servodevelop/touch-r1-leader-arm/hardware/robot-description/README.zh.md

# Touch R1 Leader Arm 机器人描述

文档已统一使用中文，正文请查看 [当前文档](README.md)。

[查看：下载与预览](README.md#preview)

[查看：模型来源](README.md#sources)

[查看：关节与坐标](README.md#kinematics)

[查看：待确认参数](README.md#confirmation)

[查看：验证与重新生成](README.md#validation)
