servodevelop/touch-r1-leader-arm/hardware/robot-description/preview/index.html

# Touch R1 Leader Arm

V3.2 · J7 舵机与双 Finger · 七轴运动学预览

预览草案 · 实机参数待确认

装配姿态 / 关节零位

七个舵机已装配 · 橙色为左右 Finger

结构件舵机旋转轴

正在加载 URDF 和 CAD 网格…

拖动旋转视角 · 滚轮缩放 · 右键平移

## 关节角度

拖动滑块查看运动。0° 对应源装配姿态。J1–J6 ±90°、J7 0–25° 仅为演示范围。

恢复装配姿态视角复位

显示旋转轴 按连杆着色

双 Finger 按 CAD 齿形推定 1:1 反向联动，待实物确认。实机限位、编码器零位和正方向未确认；未加入碰撞检测、质量及惯量。仅用于外形与运动学核对。

下载 URDF完整资源包

URDF 使用米与弧度。A000、B000 限位块已移除。舵盘随下游连杆旋转，机壳随上游连杆移动。
