servodevelop/touch-r1-leader-arm/hardware/step/parts/touch-r1-handle-assembly.step

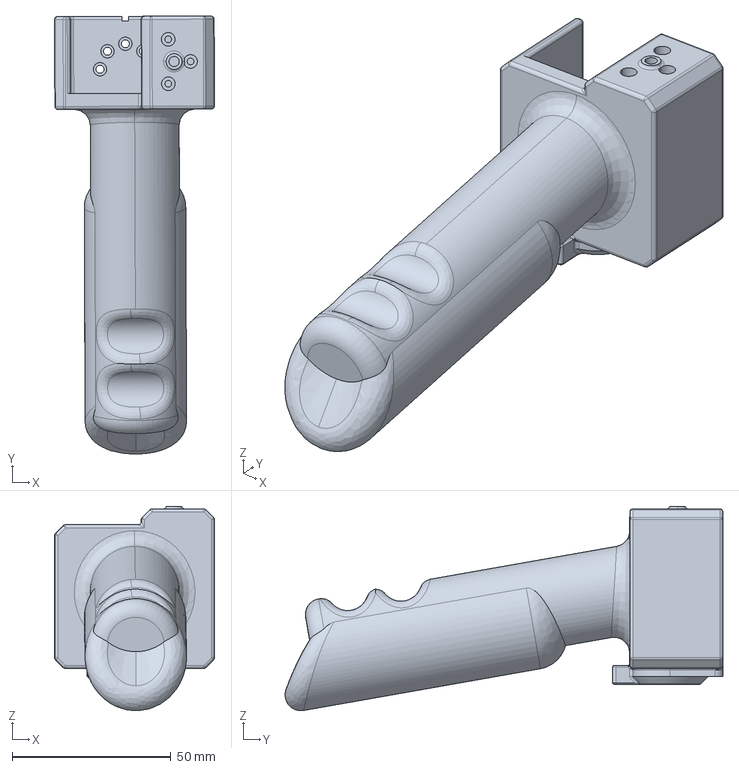
[picture p21: CAD file, 2026-10-23]
hardware/step/parts/touch-r1-handle-assembly.step
50.4 x 138.0 x 64.4 mm
