servodevelop/touch-r1-leader-arm/hardware/printing/stl/touch-r1-part-a000.stl

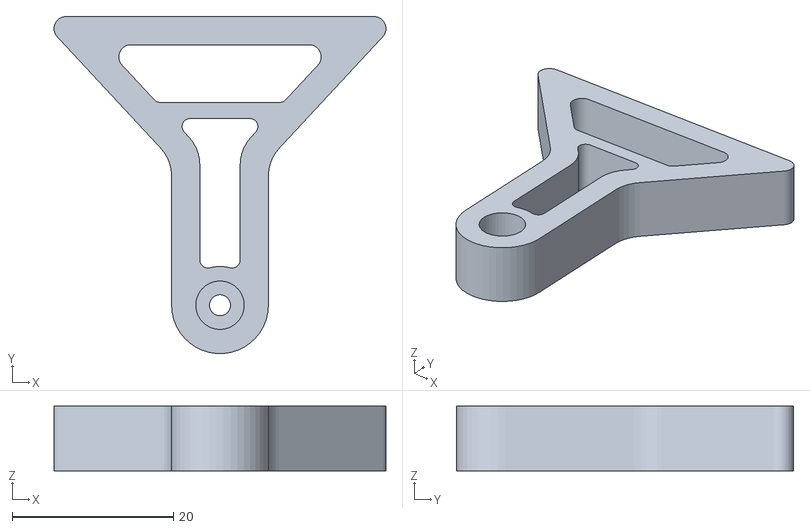
[picture p22: CAD file, 2026-10-23]
hardware/printing/stl/touch-r1-part-a000.stl
41.1 x 41.7 x 8.00
