servodevelop/touch-r1-leader-arm/hardware/robot-description/source/r1-hd-urdf-only.FCStd

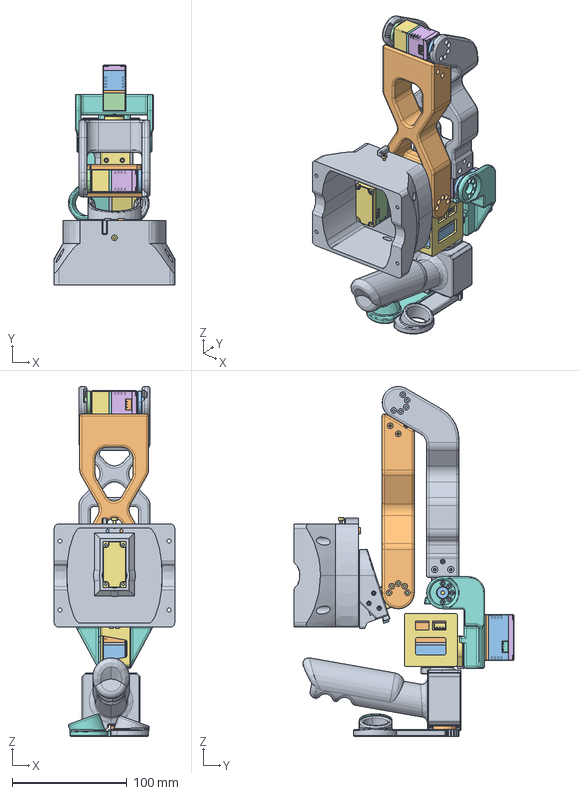
[picture p23: CAD file, 2026-10-21]
hardware/robot-description/source/r1-hd-urdf-only.FCStd
105.0 x 191.5 x 304.9 mm
_X2_51738282_X0_1_NEW
MAIN-HORN-25T-8HOLES-3D_STEP_1_
_________RA8-RP8-RX8-SERIES-3D_
____-_____RA8-RP8-RX8-SERIES-3D
_____________RA8-RP8-RX8-SERIES
_________1_STEP
_X2_57AB7247_X0_
_X2_51738282_X0_2__X2_65B0_X0_
PRT0001
PRT0002
_X2_51738282_X0_3
_X2_51738282_X0_4
_X2_51738282_X0_5_NEW
MAIN-HORN-25T-8HOLES-3D_STEP_1_001
_________RA8-RP8-RX8-SERIES-3D_001
____-_____RA8-RP8-RX8-SERIES-3D001
_____________RA8-RP8-RX8-SERIES001
_________1_STEP001
_X2_51738282_X0_6_NEW
MAIN-HORN-25T-8HOLES-3D_STEP_1_002
_________RA8-RP8-RX8-SERIES-3D_002
____-_____RA8-RP8-RX8-SERIES-3D002
_____________RA8-RP8-RX8-SERIES002
_________1_STEP002
GB_T70_1-M3X400
M2X4X30001
M2X4X30002
MAIN-HORN-25T-8HOLES-3D_STEP_1_003
_________RA8-RP8-RX8-SERIES-3D_003
____-_____RA8-RP8-RX8-SERIES-3D003
_____________RA8-RP8-RX8-SERIES003
_________1_STEP003
LEFT_ZHUA
RIGHT_ZHUA
