servodevelop/touch-r1-leader-arm/hardware/step/parts/touch-r1-joint-4.step

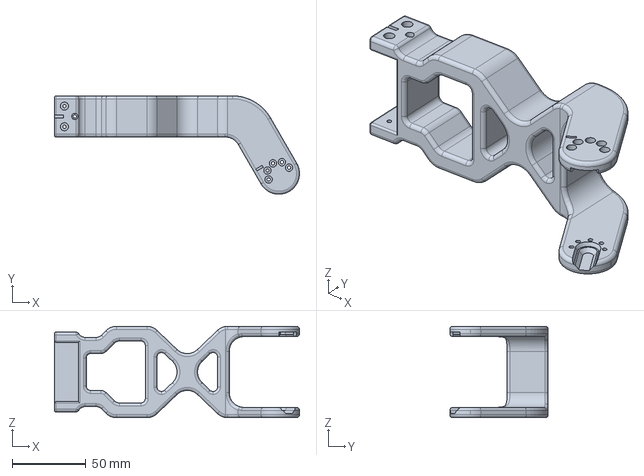
[picture p25: CAD file, 2026-10-23]
hardware/step/parts/touch-r1-joint-4.step
166.2 x 66.7 x 62.0 mm
