servodevelop/touch-r1-leader-arm/hardware/stl/touch-r1-joint-6.stl

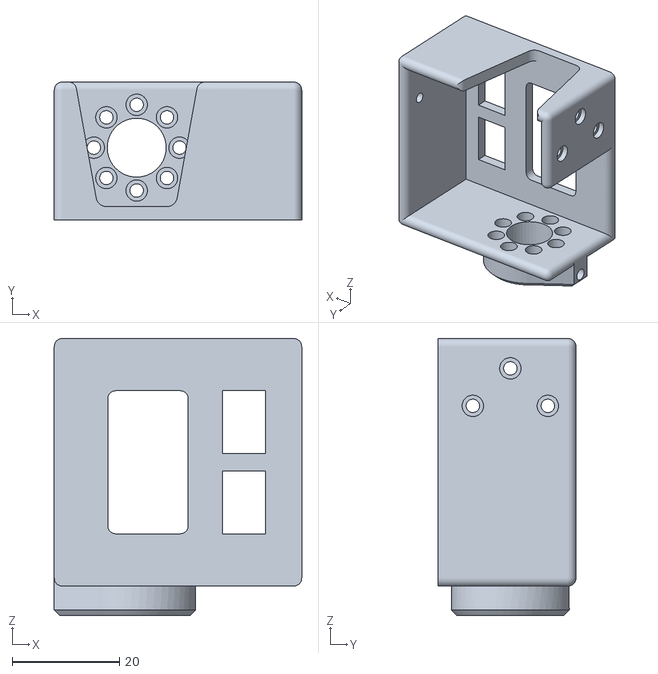
[picture p26: CAD file, 2026-10-23]
hardware/stl/touch-r1-joint-6.stl
46.2 x 25.8 x 51.7
