servodevelop/touch-r1-leader-arm/hardware/step/parts/touch-r1-joint-1.step

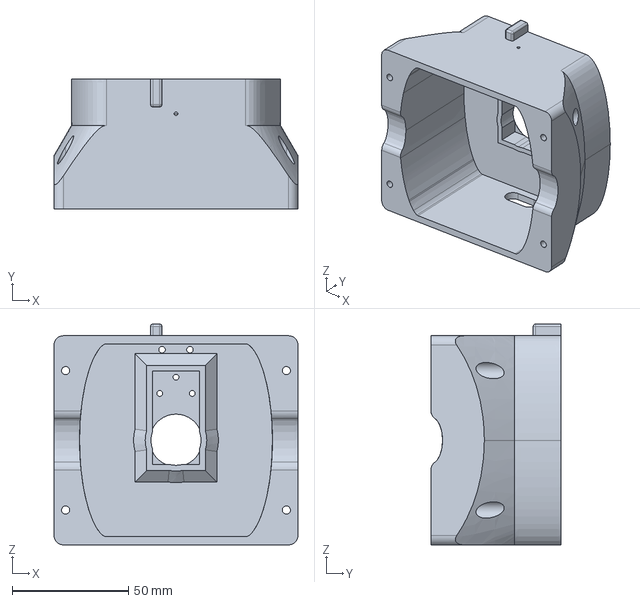
[picture p27: CAD file, 2026-10-23]
hardware/step/parts/touch-r1-joint-1.step
105.0 x 56.0 x 95.0 mm
