servodevelop/touch-r1-leader-arm/hardware/step/parts/touch-r1-joint-3.step

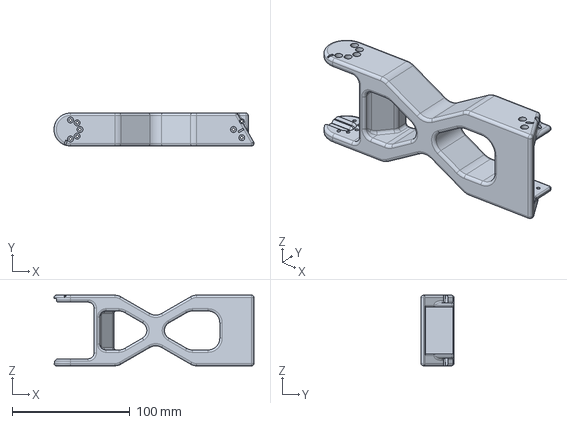
[picture p28: CAD file, 2026-10-23]
hardware/step/parts/touch-r1-joint-3.step
169.8 x 28.0 x 60.0 mm
