servodevelop/touch-r1-leader-arm/hardware/step/parts/touch-r1-joint-5.step

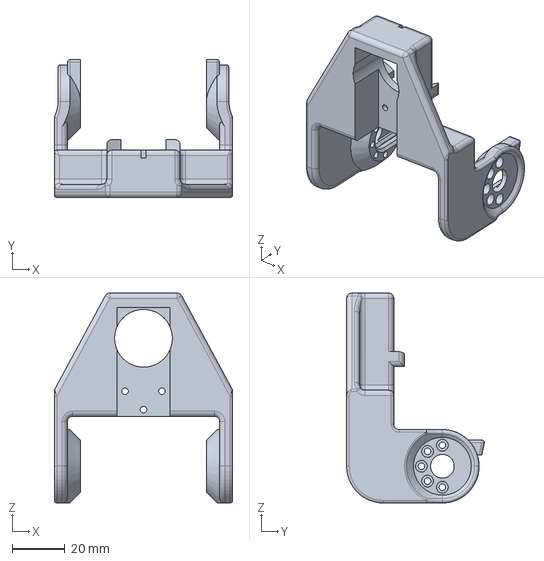
[picture p29: CAD file, 2026-10-23]
hardware/step/parts/touch-r1-joint-5.step
68.0 x 52.5 x 80.0 mm
