servodevelop/touch-r1-leader-arm/hardware/step/parts/touch-r1-joint-2.step

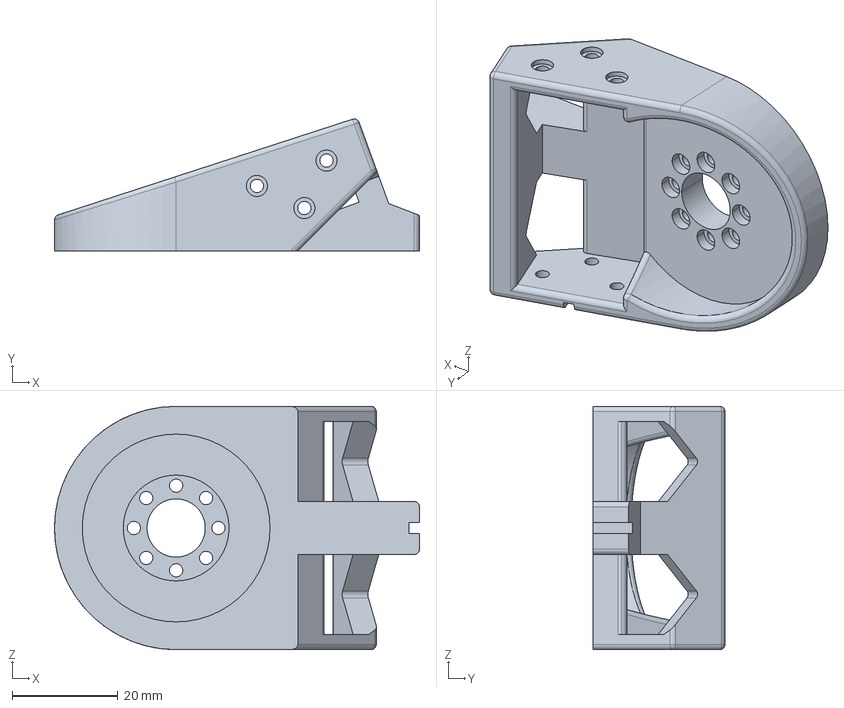
[picture p30: CAD file, 2026-10-23]
hardware/step/parts/touch-r1-joint-2.step
69.0 x 25.0 x 46.0 mm
