servodevelop/touch-r1-leader-arm/hardware/step/parts/touch-r1-fastener-prt0007.step

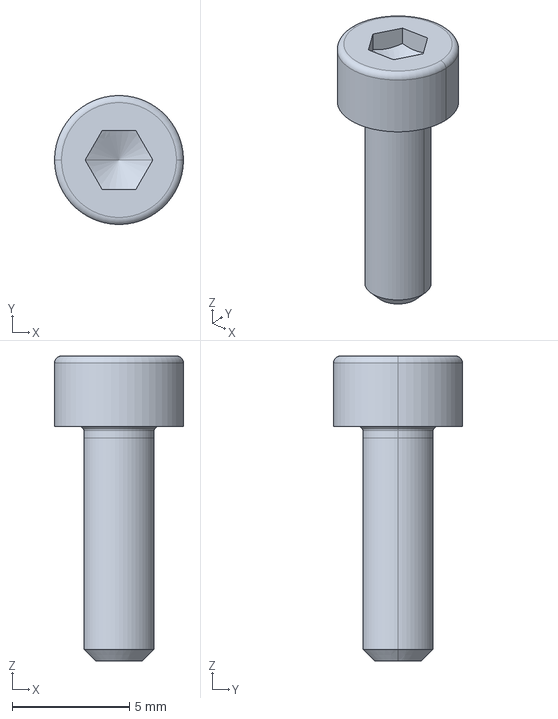
[picture p31: CAD file, 2026-10-23]
hardware/step/parts/touch-r1-fastener-prt0007.step
5.50 x 5.50 x 13.0 mm
