servodevelop/touch-r1-leader-arm/hardware/step/parts/touch-r1-fastener-gb-t70-1-m3x530001.step

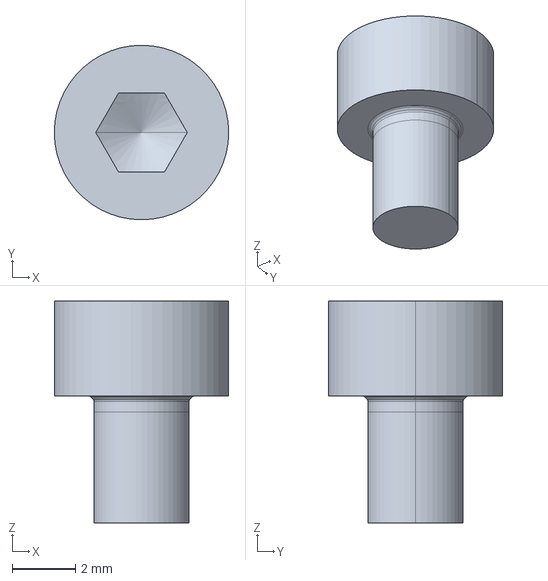
[picture p32: CAD file, 2026-10-23]
hardware/step/parts/touch-r1-fastener-gb-t70-1-m3x530001.step
5.50 x 5.50 x 7.00 mm
