servodevelop/touch-r1-leader-arm/hardware/step/parts/touch-r1-base-plate.step

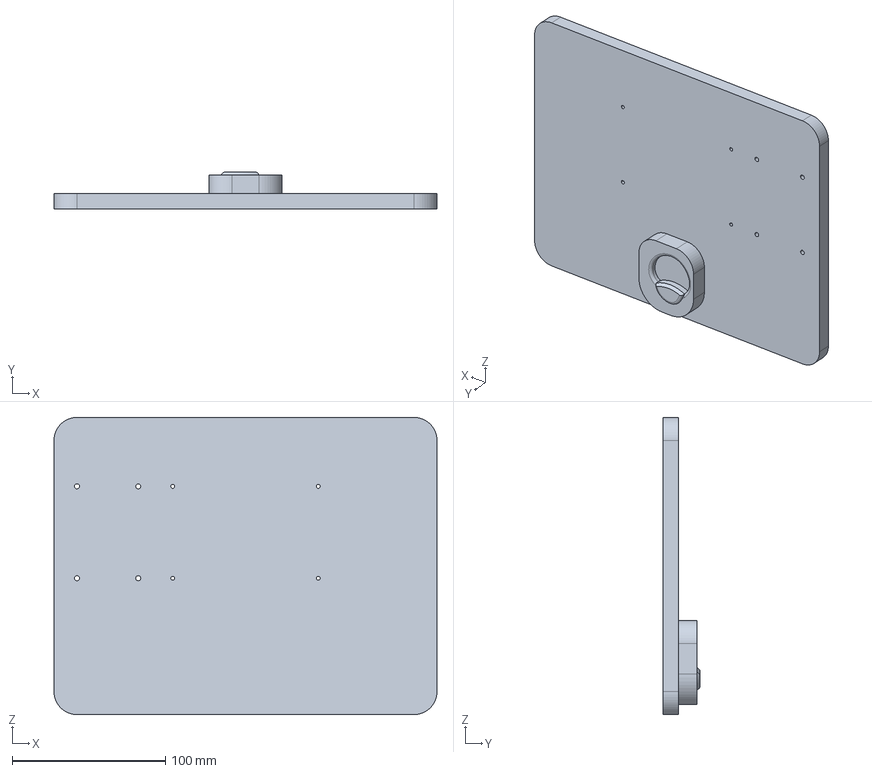
[picture p33: CAD file, 2026-10-23]
hardware/step/parts/touch-r1-base-plate.step
250.0 x 24.2 x 194.0 mm
