servodevelop/touch-r1-leader-arm/hardware/step/parts/touch-r1-finger-right.step

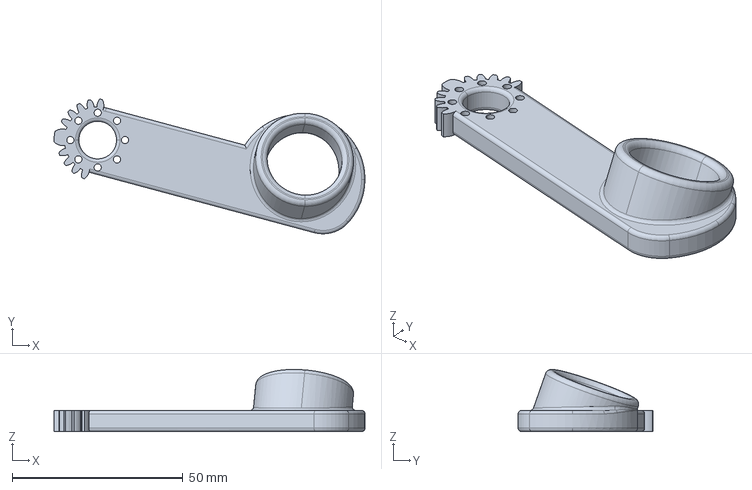
[picture p34: CAD file, 2026-10-21]
hardware/step/parts/touch-r1-finger-right.step
91.1 x 39.4 x 18.2 mm
