servodevelop/touch-r1-leader-arm/hardware/step/parts/touch-r1-finger-left.step

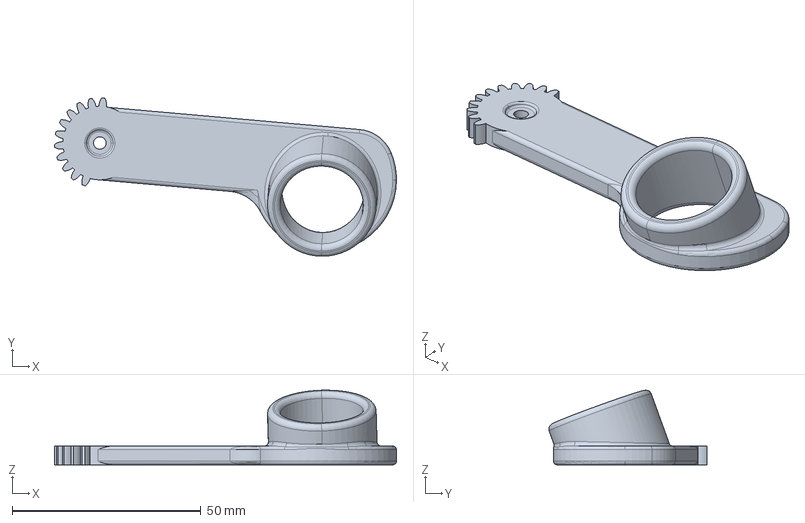
[picture p35: CAD file, 2026-10-21]
hardware/step/parts/touch-r1-finger-left.step
90.6 x 42.0 x 19.8 mm
