servodevelop/touch-r1-leader-arm/(list of files, cad)

Other CAD files:
hardware/step/assembly/touch-r1-leader-arm-v3.2-1013.stp
hardware/printing/stl/touch-r1-base-plate.stl
hardware/printing/stl/touch-r1-finger-left.stl
hardware/printing/stl/touch-r1-handle-assembly.stl
hardware/printing/stl/touch-r1-joint-1.stl
hardware/printing/stl/touch-r1-joint-3.stl
hardware/printing/stl/touch-r1-joint-4.stl
hardware/printing/stl/touch-r1-joint-5.stl
hardware/stl/touch-r1-finger-right.stl
hardware/stl/touch-r1-joint-2.stl
