servodevelop/touch-r1-leader-arm/(commit log)

2026-10-19 docs(hardware): 补充 6 种装配实物所需的采购标准件
    新增「采购补充件」章节，列出不在 V3.1 装配模型中的内六角圆柱头螺钉
    M2 × 8（16）、十字槽盘头自攻螺钉 PB2.0 × 5（21）、十字槽盘头螺钉
    M2 × 4.5（52）、十字槽盘头螺钉 M3 × 10（1）、螺母 M3（1）、
    平垫圈 M3（1），品名与规格写法沿用 102-FL 同款件。
    bom.json 与 STEP 导出件不变；README.zh.md 兼容页同步重新生成。
2026-10-20 生成 Touch R1 六轴 URDF 与交互预览
    基于装配体及两款 RP8-U45H 舵机 STEP 生成 7 个连杆、6 个关节和 21 个可视网格，记录坐标转换、关节轴及源文件校验信息。新增离线依赖的中文交互预览、完整下载包及可复现生成和检查脚本。
    关节采用 continuous 仅供运动学预览；真实限位、机械零位、辅助件归属及动力学参数保留待确认标注。
    验证：URDF 树和零位正运动学、网格尺寸和哈希、独立 URDF 解析、ZIP 资源引用、文档链接及中文入口检查均通过；浏览器已验证六轴滑块、复位与配色切换。
2026-10-20 改用去除限位块的 FCStd 重新生成 URDF
    直接读取新 FCStd 装配树的 97 个实体叶节点，移除 A000、B000 限位块，避免从旧 BOM 回填几何或重复导入父装配缓存。保留两款 RP8 舵机模型及六轴坐标，更新网格、来源记录、预览和完整下载包。
    增加源文件校验、实体唯一归属和旧网格残留检查。已通过几何生成、URDF 结构与独立解析、ZIP 完整性及资源引用、文档检查，并在内置浏览器验证六轴滑块和复位。当前仍为运动学预览，实机限位与动力学参数待确认。
2026-10-20 fix(hardware): 按实物把两个紧固件更正为标准采购件
    原「内六角圆柱头螺钉 M3 × 4」与「内六角台阶螺钉」识别错误。按实物更正为
    304 薄头内六角平尾自攻螺丝 HB3 × 5（3 件）与 304 塞打螺丝 Ø2.5 × M2 × 3
    （2 件），并入「采购补充件」章节与其余标准件合成 8 项采购清单（序号 13–20），
    CAD 提取清单相应保留 1–12 行。
    两行按型号给数据、不引用装配体；bom.json 仍按源 PRODUCT 保留 4 行并同步更正
    名称与规格，fastener_specs.py 同步更新，重新提取不会退回旧规格。
2026-10-20 新增 LeRobot 安装入口与完整实操教程
2026-10-20 规范 LeRobot 教程结构并精简操作说明
2026-10-21 基于 V3.2 补齐 J7 舵机与双指联动 URDF
    从 V3.2 装配体生成专用 FCStd 快照，继续排除 A000、B000，原始 STEP 保留在仓库外。补齐七个舵机和双 finger，增加基于 CAD 推定的反向 mimic 关节，并同步七轴预览、渲染图、来源记录和下载包。
    验证：113 个保留源实体唯一归属；9 个连杆、7 个控制关节及 1 个从动关节；25 份网格校验、独立 URDF 解析、J7 联动计算、零位与开合姿态渲染、文档检查及 ZIP 完整性通过。本轮浏览器界面未自动验收；实机限位、零位及传动关系仍待确认。
2026-10-21 加入 V3.2 原始 STEP 装配体及下载入口
    原样保存用户提供的 V3.2 STEP，更新硬件入口、URDF 来源说明、重建命令及资源包记录。明确现有 BOM 和零件导出件适用于 V3.1。
    验证：原始 STEP SHA-256 与附件及既有 URDF 来源记录一致；文档链接、中文入口、URDF 资源校验及 ZIP 完整性检查通过。
2026-10-21 fix(hardware): BOM 与零件导出件补齐到 V3.2
    按 V3.2 装配体重建物料清单与独立零件导出件：CAD 清单 12 → 14 行
    （RP8 舵机 3 → 4，新增手柄装配、左手指、右手指），移除 V3.2 中已不存在的
    关节 7，源装配体改为上游入库的 touch-r1-leader-arm-v3.2-1013.stp。
    bom.json 重算为 18 项 / 24 个顶层实例 / 115 个叶级实体；step/parts 共 18 份，
    其中几何未变的 15 份保持原字节不动。塞打螺丝沿用原有的导出件、图片与采购件
    条目，只在 bom.json 里记录 V3.2 的源名称 M2X4X30001。
    文档同步：装配体说明、资源目录份数、BOM 数量、验证状态均改为以 V3.2 为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
2026-10-21 feat(hardware): 物料清单合并为一张总表并补齐配件
    按实物与 102 同型件补齐整套物料：舵机改为 RP8-U45H-M-C028（4 件）与
    RP8-U45H-M（3 件）；新增 HD 按钮盖／按钮座、UC-01 转接板、UK-01 按钮板、
    AXK2035+2AS 推力滚针轴承、PH2.0 120/200 mm 舵机连接线共 7 项；十字槽盘头
    自攻螺钉 PB2.0 × 5 由 21 增至 28。源名称「垫片」的实体经确认不是实际零件，
    已从清单剔除，bom.json 仍保留其 CAD 记录。
    原「采购补充件」独立章节合并为一张 28 项总表，结构件、标准件与配件连续编号；
    purchase-parts 锚点、目录条目与兼容页条目同步移除。bom.json 仅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
2026-10-21 docs(hardware): BOM 改用英文品名，连杆统一命名为 Link 1–6
    物料清单整表改为 Star Arm 102 的英文写法（No. / Part Name / Model / Specification /
    Image / Description / Quantity），品名与描述不再逐条译成中文：舵机写 UART bus servo，
    紧固件沿用 Socket-head cap screw、Phillips pan-head screw 等 102 措辞，
    配件写 HD button cover、UC-01、UK-01、AXK2035+2AS、Servo cable。
    第 3–8 行由「Joint N structure」改为「Link N」；Model 列仍指向
    step/parts/touch-r1-joint-N.step，标识与文件未改名。
    仅表格措辞变化：数量、图片、链接与 bom.json 均未改动。
2026-10-23 feat(hardware): 装配体换 V3.3，补齐 17 份零件 STEP 与 11 份 STL
    V3.3 装配体（遥操臂V3.3_1023.stp）入库并作为 BOM 与导出件依据：
    新增 0002 底座，删除 B000 支架，三颗自攻螺丝合并为 GB_T70_1-M3X530001
    且头厚由 2.00 改为 3.00 mm，塞打螺丝 2 件减为 1 件，新增 M3 × 10
    内六角圆柱头螺钉 PRT0007，Link 1–5 与手柄装配有几何修改。
    - step/parts 17 份，几何未变的 8 份保持原字节
    - printing/stl 新增 11 份闭合二进制 STL（0.05 mm 线性偏差）
    - images 重渲 Link 1–5、手柄、装配体，新增底座、PRT0007、自攻螺丝
    - BOM 28 → 29 行，底座与 PRT0007 入表，塞打螺丝数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
2026-10-23 refactor(hardware): 打印文件改为 stl/ 并补下载包，标准件不再导出 STEP
    参照 Star Arm 102 的 LD 目录结构整理：
    - 删除 hardware/printing/（stl 与 3mf 两个空壳目录），STL 移到 hardware/stl/
    - hardware/stl/ 放 11 份散件，另加 downloads/touch-r1-stl-2026-10-23.zip
    （包内为 touch-r1-stl/ 目录，条目与散件逐字节一致）
    - step/parts 由 17 份减为 14 份：三种标准紧固件
    GB_T70_1-M3X530001、M2X4X30001（塞打螺丝）、PRT0007 不再导出 STEP，
    只在 BOM 与 bom.json 里保留来源与规格
    - extract_step_bom.py 增加 NO_STEP_EXPORT、STL_ARCHIVE，
    --stl-dir 默认改为 hardware/stl，生成下载包并核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
